x2nie/embroiderino/electronics/encoder/encoder.kicad_pcb

## KiCad design electronics/encoder/encoder.kicad_pcb (2018-11-04)

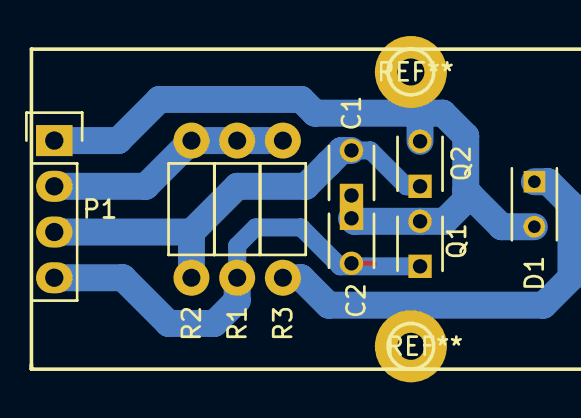
[picture p1: board encoder.kicad_pcb from above]

Board: 2 copper layers, 9 parts (0 on the bottom side), 5 nets.

Parts:
C1, C2: 100n; C_Disc_D3_P2.5
D1: LED; C_Rect_L4_W2.5_P2.5
P1: CONN_01X04; Pin_Header_Straight_1x04
Q1, Q2: OPTO_NPN; C_Disc_D3_P2.5
R1, R2: 10K; Resistor_Horizontal_RM7mm
R3: 550R; Resistor_Horizontal_RM7mm

Connections:
GND: P1.2, R1.2, R2.2, R3.2
unnamed: C1.2, P1.3, Q2.1, R2.1
unnamed: C2.2, P1.4, Q1.1, R1.1
unnamed: D1.1, R3.1
VCC: C1.1, C2.1, D1.2, P1.1, Q1.2, Q2.2
