x2nie/embroiderino/electronics/power_driver/power_driver.kicad_pcb

## KiCad design electronics/power_driver/power_driver.kicad_pcb (2018-10-21)

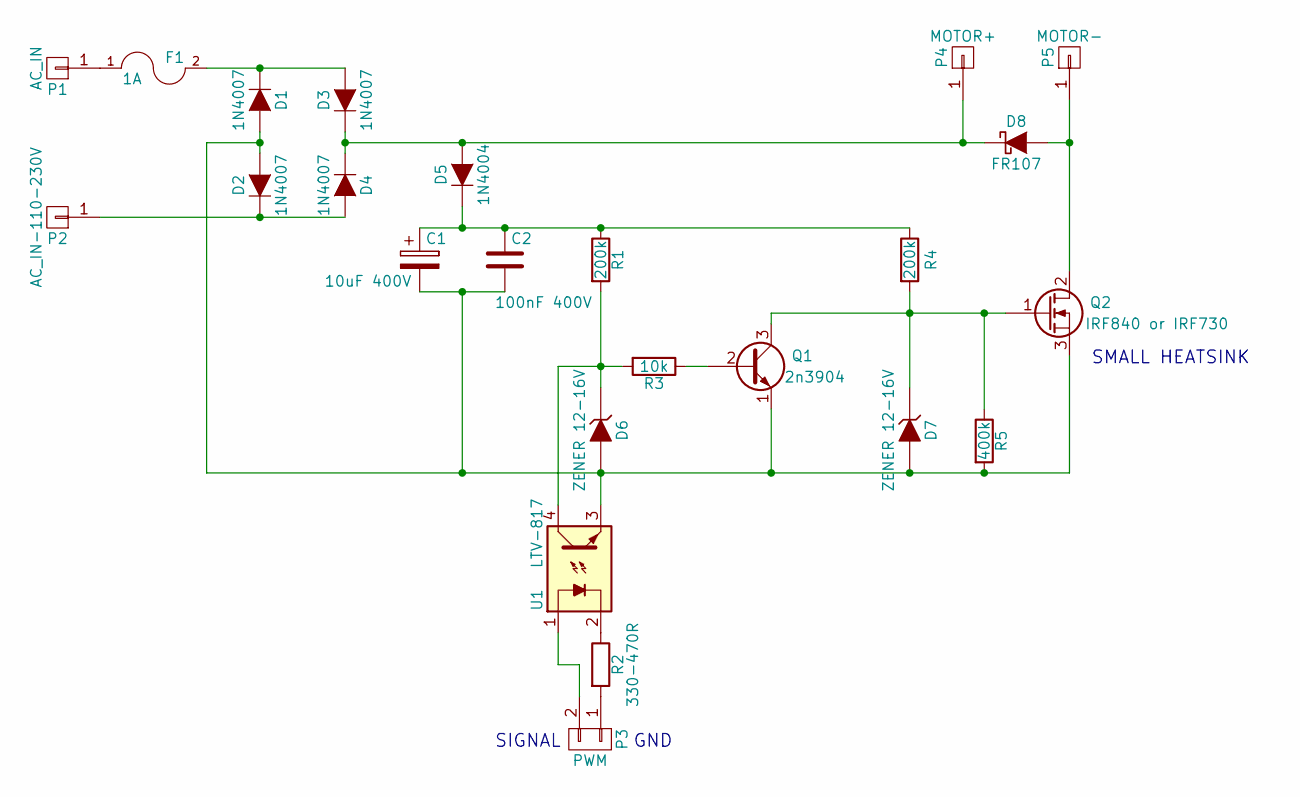
[picture p2: schematic power_driver.sch, MOSFET power driver]

Parts:
C1: 10uF 400V; C_Rect_L7_W4.5_P5
C2: 100nF 400V; C_Radial_D8_L11.5_P3.5
D1, D2, D3, D4: 1N4007; Diode_DO-41_SOD81_Horizontal_RM10
D5: 1N4004; Diode_DO-41_SOD81_Horizontal_RM10
D6, D7: ZENER 12-16V; Diode_DO-35_SOD27_Horizontal_RM10
D8: FR107; Diode_DO-41_SOD81_Horizontal_RM10
F1: 1A; Fuseholder5x20_horiz_open_inline_Type-I
P1: AC_IN; 1pin
P2: AC_IN-110-230V; 1pin
P3: PWM; Pin_Header_Straight_1x02
P4: MOTOR+; 1pin
P5: MOTOR-; 1pin
Q1: 2n3904; TO-92_Inline_Wide
Q2: IRF840 or IRF730; TO-220_Neutral123_Vertical
R1, R4: 200k; Resistor_Horizontal_RM7mm
R2: 330-470R; Resistor_Horizontal_RM7mm
R3: 10k; Resistor_Horizontal_RM7mm
R5: 400k; Resistor_Horizontal_RM7mm
U1: LTV-817; DIP-4_W7.62mm_LongPads

Connections:
unnamed: C1.1, C2.1, D5.1 (K), R1.1, R4.1
unnamed: C1.2, C2.2, D1.2 (A), D2.2 (A), D6.2 (A), D7.2 (A), Q1.1 (E), Q2.3 (S), R5.2, U1.3
unnamed: D1.1 (K), D3.2 (A), F1.2
unnamed: D2.1 (K), D4.2 (A), P2.1
unnamed: D3.1 (K), D4.1 (K), D5.2 (A), D8.1 (K), P4.1
unnamed: D6.1 (K), R1.2, R3.2, U1.4
unnamed: D7.1 (K), Q1.3 (C), Q2.1 (G), R4.2, R5.1
unnamed: D8.2 (A), P5.1, Q2.2 (D)
unnamed: F1.1, P1.1
unnamed: P3.1, R2.2
unnamed: P3.2, U1.1
unnamed: Q1.2 (B), R3.1
unnamed: R2.1, U1.2

Notes on the sheet:
SMALL HEATSINK
GND
SIGNAL

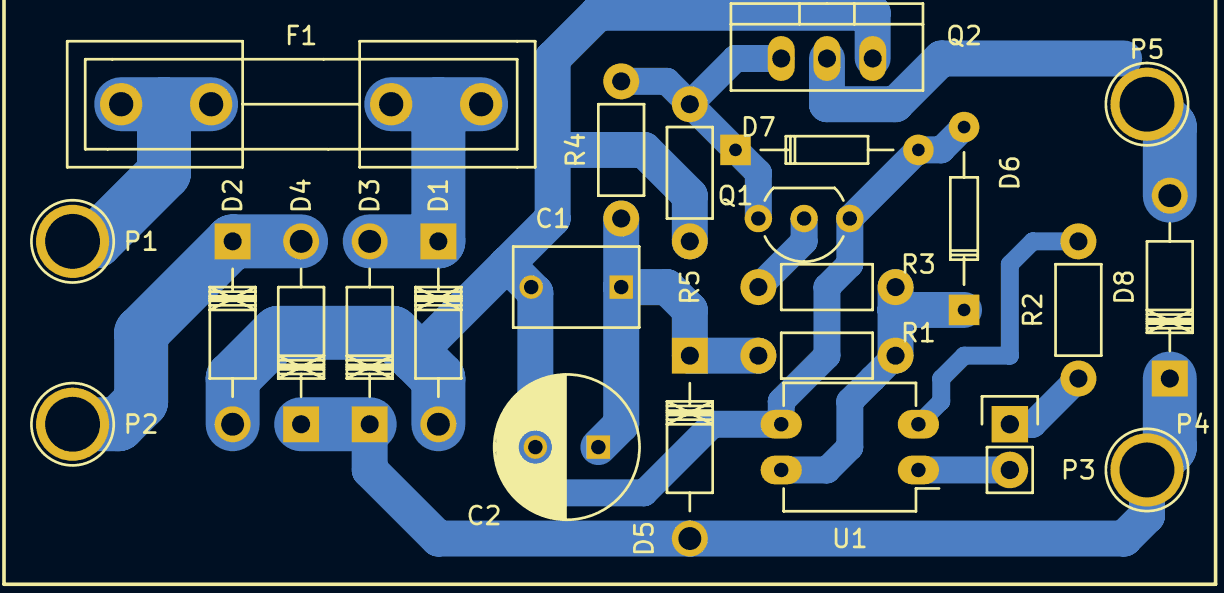
[picture p3: board power_driver.kicad_pcb from above]

Board: 2 copper layers, 24 parts (0 on the bottom side), 13 nets.
