x2nie/embroiderino/(commit log)

2018-10-01 Inital commit, added client application and scad files.
    [anchor_mount.scad, hoop.scad, hoop_plotter_adapter.scad, knoob.scad, motor_encoder_parts.scad, needle_encoder_parts.scad, plotter_mount.scad, polyround.scad]
2018-10-21 Added power driver PCB KiCad project.
    [power_driver.kicad_pcb, power_driver.sch]
2018-10-22 Added job auto pausing options, fixed job time estimation.
    [app.py, control_serial_mockup.py, path_preview.py]
2018-10-25 Added speed control slider, design area check, exit confirm dialog fix, in progress percentage.
    [app.py]
2018-11-04 Included sensor board KiCad files.
    [encoder.kicad_pcb, encoder.sch]
2018-11-09 Refactor of hoop scad code, minor changes in other models.
    [hoop.scad, hoop_plotter_adapter.scad, motor_encoder_parts.scad]
2018-11-10 Test design for large hoop.
    [hoop.scad, hoop_large.scad]
2024-08-01 sample js to real serial-port (my = virtual port)
